HeroMar/THP_sensor_device/(threads)

Thread 2 (2023-02-15):

THP sensor compensation

HeroMar, 2023-02-15:
Compensation of the temperature, humidity and pressure sensor to eliminate heating effect of the ESP module.

Closed 2023-11-17.
